lufla/CIC_Testing/docs/QC Testing Overview.pdf

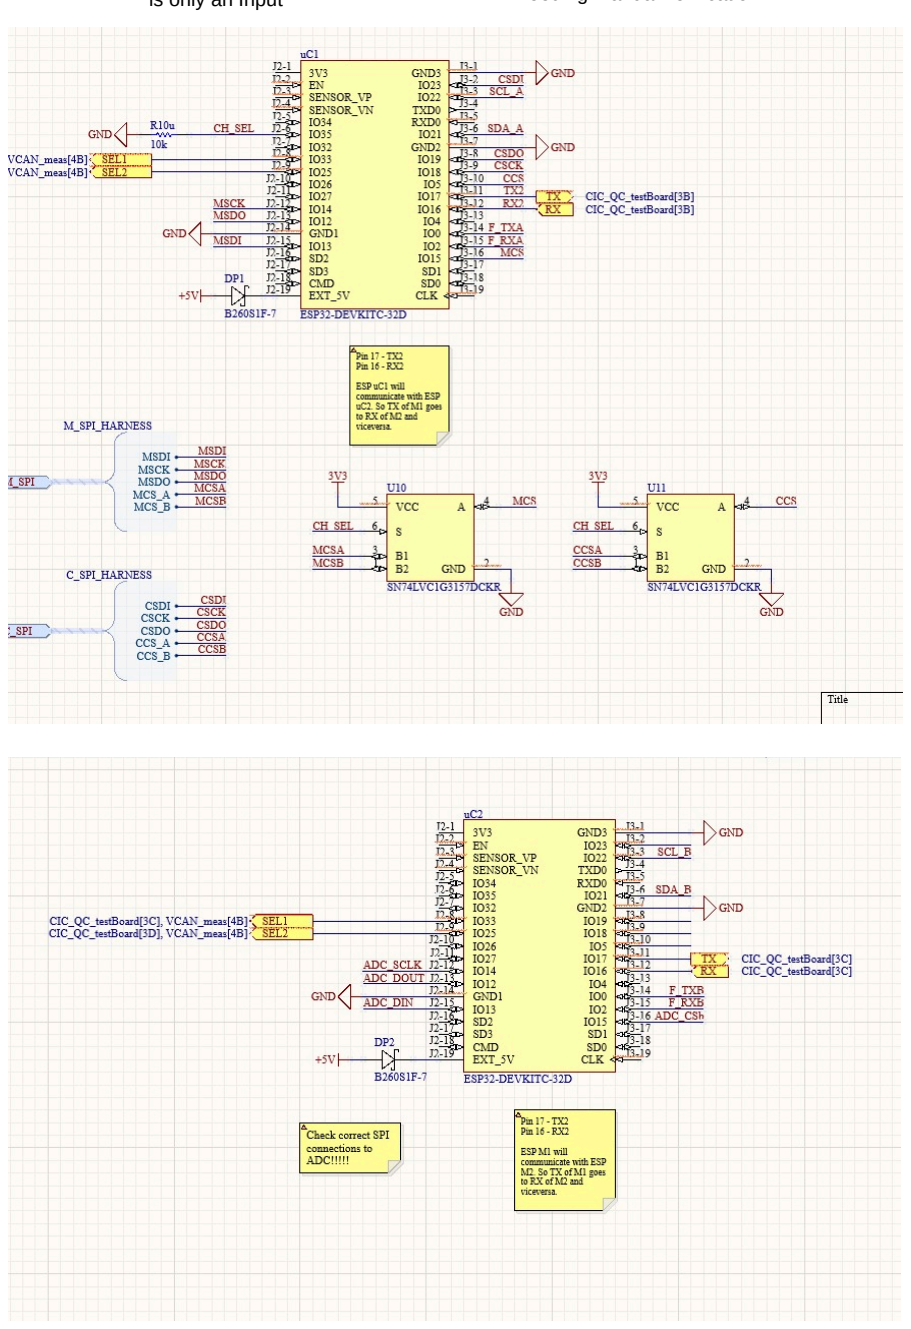
[picture p1: figure]

SPI (M read ADC messurements)

UART (Sent log of: - CAN A & B of RX/TX - VCAN V & A of CIC - VCAN V A & B - CIC ADC mesurements -Master has set ID (needed for connecting multiple QA Tester at once) This ID will be pressent in the terminal TXD0/RXD0

Master

First execute 3.2 - 3.3 if it work, only then let it run at max. V & C for 9min to heatup, then

start with the CAN 3.5 - 3.6! 3.4 in parallel to 3.2-3.6, also on slave in parallel Count CAN errors like CRC or error Frames

UART TX/RX
| (Sent & Receive CAN messages + Crosstalk (both directions depending on Crosstalk direction test),
| VCAN V & A, Power ADC)

Slave First execute 3.2 - 3.3 if it work, only then let it run at max. V & C for 9min to heatup, then

start with the CAN 3.5 - 3.6! 3.4 in parallel to 3.2-3.6, also on master in parrallel Count CAN errors like CRC or error Frames

Voltage & Current for Bus M comp.: CIC power (3V3) | Voltage & Current for SPI C comp.: ADC of the CIC (VCAN)

ADC 4x
channel

SPI (ADC readout V & A for CIC C & M)

I²C A(read V & set current (only set after VCAN Voltage was set))

Voltage, GND and Current of VCAN A

VCAN
+/-

I²C A(read V & set current (only set after VCAN Voltage was set)) VCAN
+/-

SPI (C set Voltage of the VCAN A & B)

F_TXB/F_RXB (CAN communication) TX: 0x580 + NodeID, msg 0 RX: 0x700 + NodeID, msg 0

F_TXA/F_RXA (CAN communication) TX: 0x580 + NodeID, msg 0 RX: 0x700 + NodeID, msg 0

PC

Python script

Menue + Options: 1. Enter Serial Number or use Barcode Scanner After 1 Print SN, Name, Date, Time

2. All values OK? (Name, Date, Time, etc. Time and Date autimatical) 2.1 Editor menue

2.2 OK, then 3. 3.1 START ALL

3.2 Test Voltage CH: A| B| Both (Only A or B at the same time) 3.3 Test Current CH: A| B| Both (Only A or B at the same time and Voltage must be set before current) 3.4 Test Temperature CH: A| B| Both (Only A or B at the same time) 3.5 Test CAN CH: A| B| Both (for 1 min or 1000msg?) 3.6 Test Crosstalk CH: A aktive| B aktive (for 1 min or 1000msg?) 4. After 3.1,.2,....6: Display results and then Save & END + override file if already existing|| repeat 1.X, 2.X or 3.X? || NEW Test with differen t CIC connected? Optional: Enter current load test (terminal: set current in a range + Ender, current is set; it changes after another commant + Enter; it ends on tpye END or end + Enter

Generate folder for each SerialNumber File: X.csv Test_all, which gets filled by (olnly when executed):

Voltage_mesurements_SerialNumber.csv Current_mesurements_SerialNumber.csv Tempreture_mesurements_SerialNumber.csv CAN_mesurements_SerialNumber.csv Crosstalk_mesurements_SerialNumber.csv

Grapth CIC_AQ_AC_123456789.csv See example: CIC_QA_QC.csv

END, upload to CERN database? Y/N New CIC connected

Level Shifter

Level Shifter

Arduino Shield NodeID = 1:
CAN Receive: ID = 0x581, msg = 00, 00, 00, 00, 00, 00, 00, 00 CAN Sent: ID = 0x701, msg = 00, 00, 00, 00, 00, 00, 00, 00 Receive and Sent is on CAN and for testing on Adruino UART

Arduino Shield NodeID = 2:
CAN Receive: ID = 0x582, msg = 00, 00, 00, 00, 00, 00, 00, 00 CAN Sent: ID = 0x702, msg = 00, 00, 00, 00, 00, 00, 00, 00 Receive and Sent is on CAN and for testing on Adruino UART

Voltage, GND and Current of VCAN B

Tell the USER to switch all SWITCHES TO OFF (A&B) initaly: Test if VCAN on CIC ADC and QC tester (I²C) stay 0V pass; then USER switch all SWITCHES TO ON. Afterwords an automated bit cobination testing (256 bits) happens to verify that only on the correct combination 1,25V;1,9V;2,0V;2,4V;2,6V;2,8V;3,5V;4,2V;4,6V

Switch Box

QA/QC
Tester | CIC

SPI C: MCP23S08-E/SO

ADC
ADC124S021CIMMX/NOPB

Voltage ADC
TLA2022IRUGR
Current DAC MCP4726A0T-E/CH

Voltage ADC
TLA2022IRUGR
Current DAC MCP4726A0T-E/CH

Main Task Set SPI ADC + values rx/tx, Set I²C ADC + values tx/tx, CAN rx/tx and forwart over UART

Main Task Set 2x SPI ADC + values rx/tx, Set I²C ADC + values tx/tx, CAN rx/tx, forwart over UART if needed and rx/tx to python

Mai task: Terminal input and output, Sent states to master, a csv, depending on 3.X, fill the CSV with the information

SPI M: CS5523-ASZ

TODO Hieraus ein flow diagram machen damit jeder nachvollziehen kann was passiert

IO 34 moved to 32, because 34
is only an Input

NEW FUNCTION 34: Master pull down Slave pull up

this is done to automate who is who, without needing manual verification
