lufla/CIC_Testing/docs/QC Testing of the CIC.drawio.pdf

UART
TXD0/RXD0
(Sent log of:
- CAN A & B of RX/TX
- VCAN V A & B
- VCAN V & A of CIC
- CIC ADC mesurements
M t h | t ID ( | d d f | ti | lti l QA T t | t | )

Python script

Menue + Options:
1. Enter Serial Number or use Barcode Scanner
After 1 Print SN, Name, Date, Time
2. All values OK? (Name, Date, Time, etc. Time and Date autimatical) 2.1 Editor menue
2.2 OK, then 3.
3.1 START ALL
3.2 Test Voltage CH: A| B| Both (Only A or B at the same time) 3.3 Test Current CH: A| B| Both (Only A or B at the same time and Voltage must be set before current) 3.4 Test Temperature CH: A| B| Both (Only A or B at the same time) 3.5 Test CAN CH: A| B| Both (for 1 min or 1000msg?)
3.6 Test Crosstalk CH: A aktive| B aktive (for 1 min or 1000msg?)
4. After 3.1,.2,....6: Display results and then Save & END + override file if already existing|| repeat 1.X, 2.X or 3.X? || NEW Test with differen t CIC connected? Optional: Enter current load test (terminal: set current in a range + Ender, current is set; it changes after another commant + Enter; it ends on tpye END or end + Enter

Gen

Test_all, w
Volta
Curre
Tempre
CAN
Cross

CIC_AQ_AC_12345
See exampl
CIC_QA_QC.

New CIC connected

PC

Mai task: Terminal input and output, Sent states to master, a csv, depending on 3.X, fill the CSV with the information

T

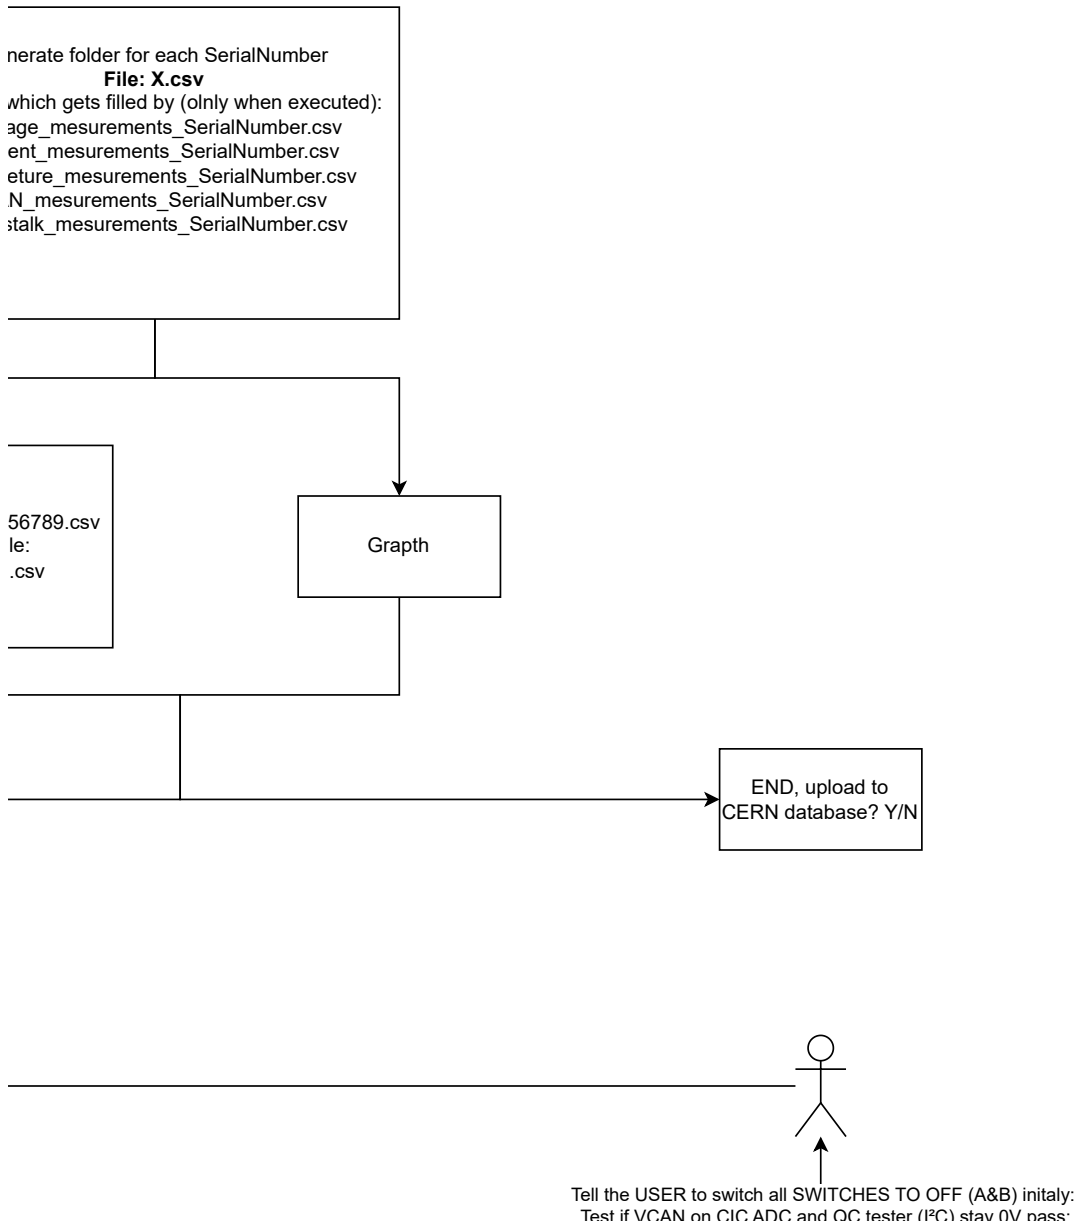
[picture p2: figure]
nerate folder for each SerialNumber File: X.csv; age_mesurements_SerialNumber.csv ent_mesurements_SerialNumber.csv eture_mesurements_SerialNumber.csv AN_mesurements_SerialNumber.csv stalk_mesurements_SerialNumber.csv; Grapth; 56789.csv le: .csv; END, upload to CERN database? Y/N

which gets filled by (olnly when executed):

Tell the USER to switch all SWITCHES TO OFF (A&B) initaly: Test if VCAN on CIC ADC and QC tester (I²C) stay 0V pass;

TODO Hieraus ein flow diagram machen damit jeder nachvollziehen kann was passiert

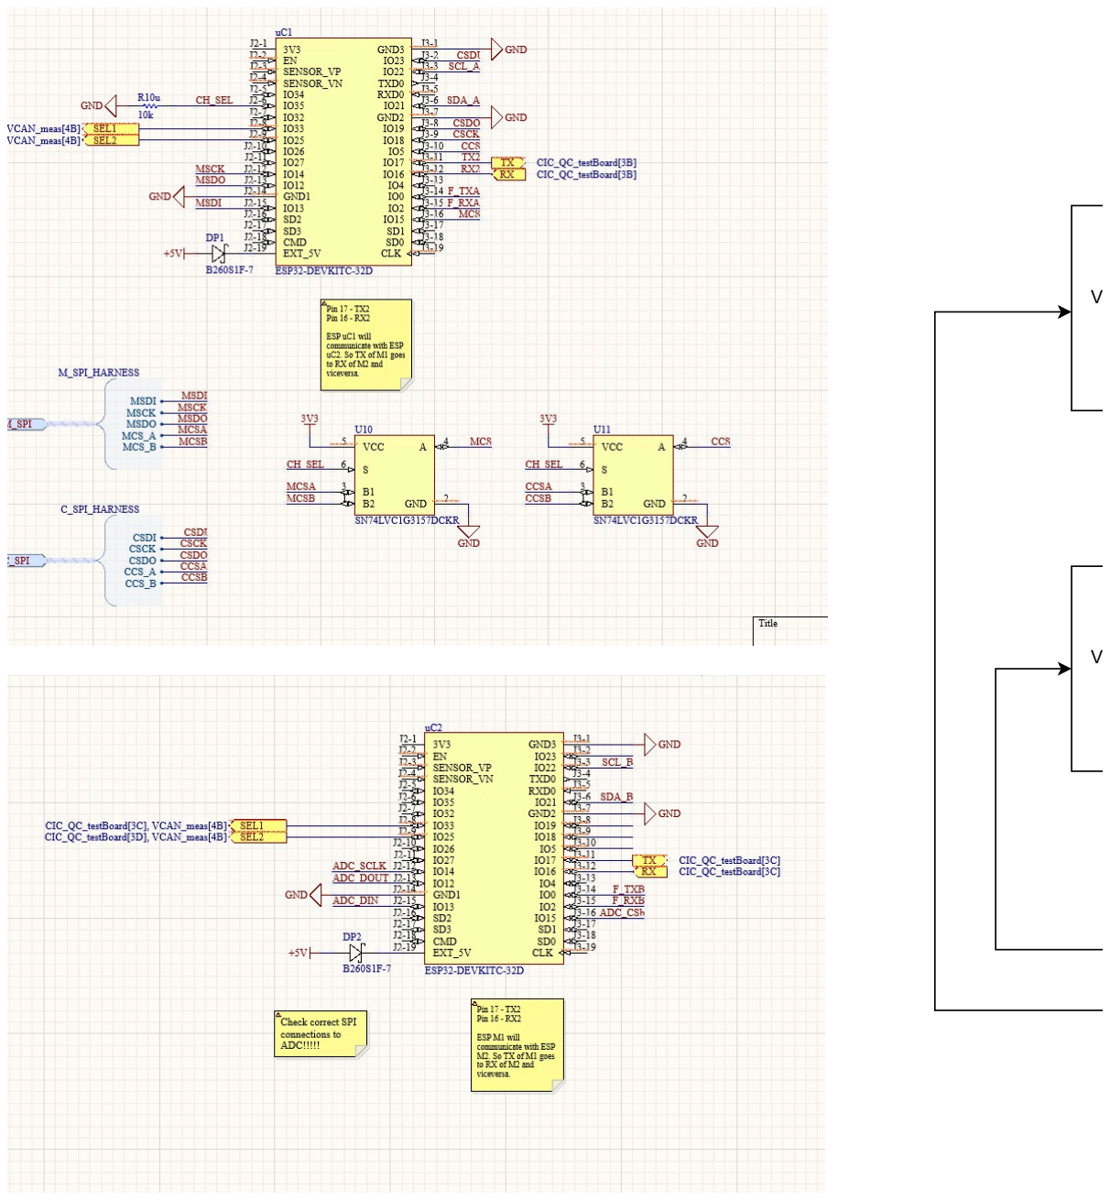
[picture p3: page 5]

VV

SPI (M read ADC messurements)

-Master has set ID (needed for connecting multiple QA Tester at once) This ID will be pressent in the terminal

Master

First execute 3.2 - 3.3 if it work, only then let it run at max. V & C for 9min to heatup, then start with the CAN 3.5 - 3.6! 3.4 in parallel to 3.2-3.6, also on slave in parallel
Count CAN errors like CRC or error Frames

UART TX/RX
| (Sent & Receive CAN messages + Crosstalk
| (both directions depending on Crosstalk direction test),
VCAN V & A, Power ADC)

Slave

First execute 3.2 - 3.3 if it work, only then let it run at max. V & C for 9min to heatup, then start with the CAN 3.5 - 3.6! 3.4 in parallel to 3.2-3.6, also on master in parrallel Count CAN errors like CRC or error Frames

Voltage & Current fo
Bus C: CIC power

SPI (ADC readout V & A for CIC C

I²C A(read V & set current (only set after VCAN Voltage was set))

Voltage, GND and Current of VCAN A

VCAN
+/-

I²C A(read V & set current (only set after VCAN Voltage was set))

VCAN
+/-

SPI (C set Voltage of the VCAN A & B)

F_TXB/F_R
TX: 0x5
RX: 0x7

F_TXA/F_RXA (CAN communication) TX: 0x580 + NodeID, msg 0
RX: 0x700 + NodeID, msg 0

Voltage, GND and Current of VCAN B

QA/QC
Tester

Voltage ADC
TLA2022IRUGR
Current DAC
MCP4726A0T-E/CH

Voltage ADC
TLA2022IRUGR
Current DAC
MCP4726A0T-E/CH

Main Task Set SPI ADC + values rx/tx, Set I²C ADC + values tx/tx, CAN rx/tx and forwart over UART

Main Task Set 2x SPI ADC + values rx/tx, Set I²C ADC + values tx/tx, CAN rx/tx, forwart over UART if needed and rx/tx to python

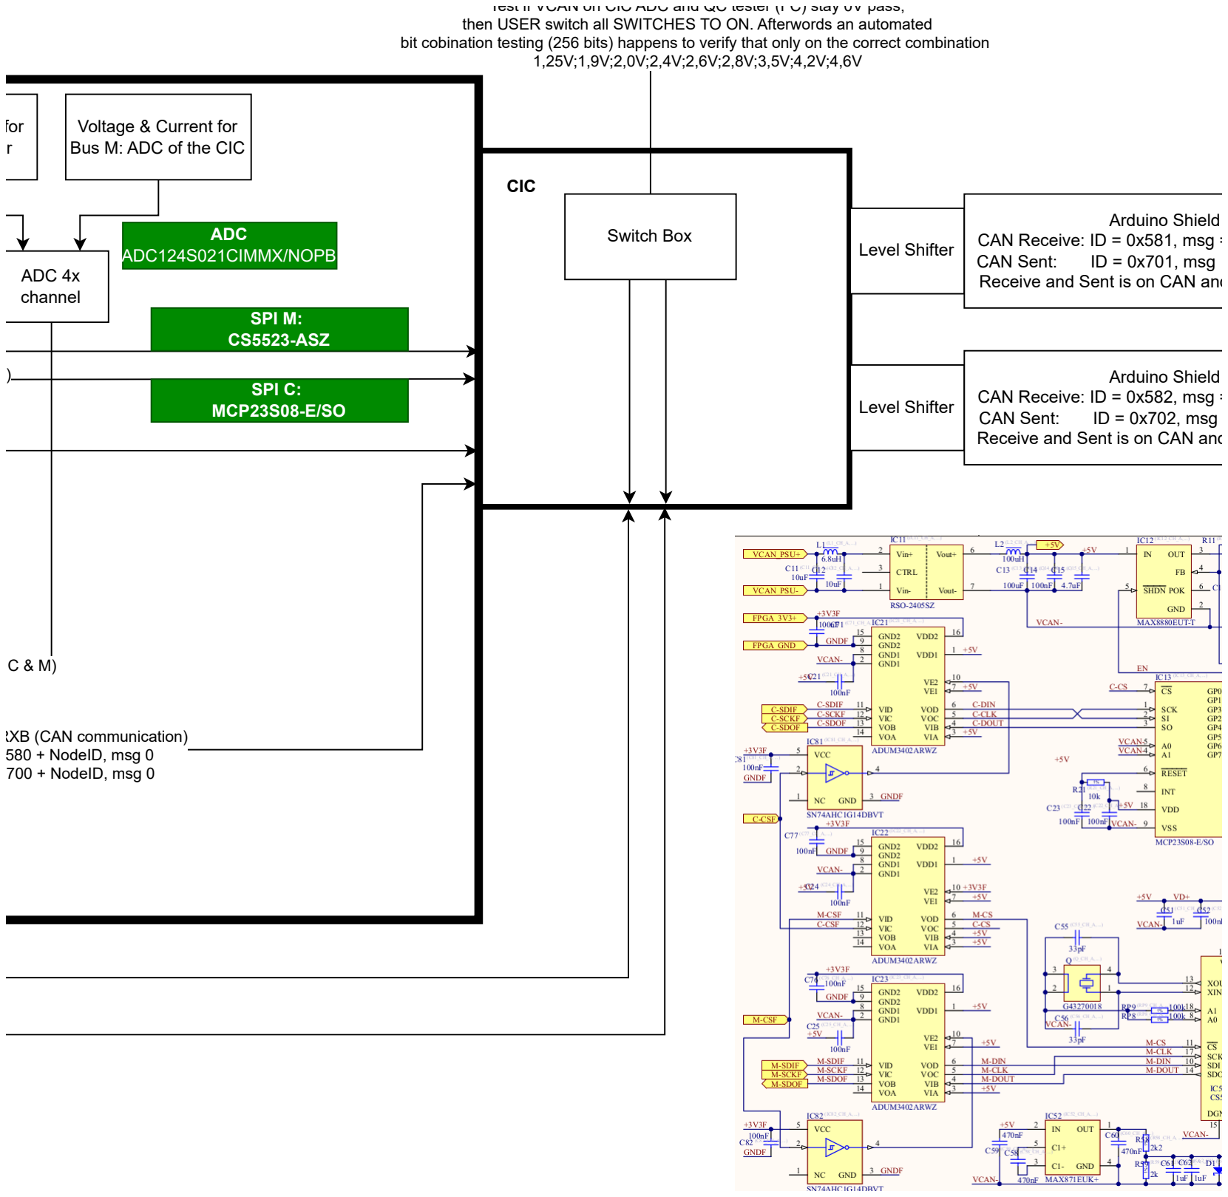
[picture p4: figure]
for r; Voltage & Current for Bus M: ADC of the CIC; ADC 4x channel; RXB (CAN communication) 580 + NodeID, msg 0 700 + NodeID, msg 0; Level Shifter; Arduino Shield CAN Receive: ID = 0x581, msg =; CAN Sent:; ID = 0x701, msg; Receive and Sent is on CAN and; Arduino Shield CAN Receive: ID = 0x582, msg =; ID = 0x702, msg; Switch Box; CIC; SPI C: MCP23S08-E/SO; ADC ADC124S021CIMMX/NOPB; SPI M: CS5523-ASZ

Test if VCAN on CIC ADC and QC tester (I C) stay 0V pass; then USER switch all SWITCHES TO ON. Afterwords an automated
bit cobination testing (256 bits) happens to verify that only on the correct combination

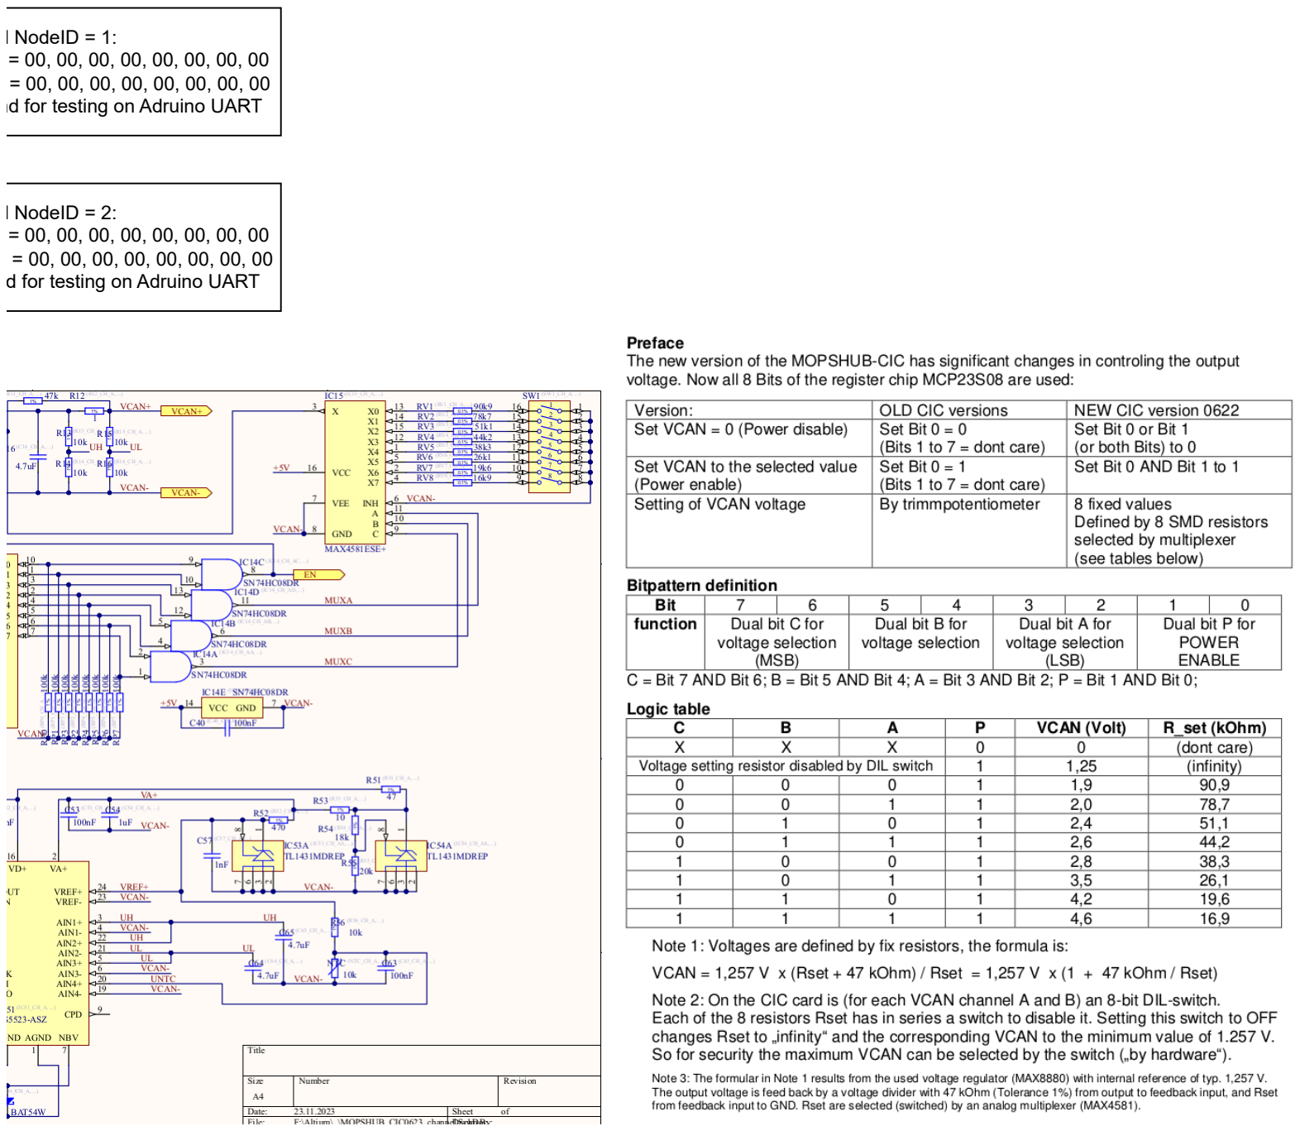
[picture p5: page 8]

d NodeID = 1:
= 00, 00, 00, 00, 00, 00, 00, 00 = 00, 00, 00, 00, 00, 00, 00, 00 nd for testing on Adruino UART

d NodeID = 2:
= 00, 00, 00, 00, 00, 00, 00, 00 = 00, 00, 00, 00, 00, 00, 00, 00 d for testing on Adruino UART
