lufla/CIC_Testing/docs/CIC_QA_QC.ods

CIC QA/QC Measurements
QA/QC Technician | Date | Time | Serial Number | Room Temperature in °C | QA_QC BOARD ID | Acceptance of the Hardware
Lukas Flad | 21.08.25 | 19:55:00 | 123456789 | 25 | 2 | FAILED
Accepted measurements | VCAN Voltage min. (-1%) | VCAN Voltage nominal | VCAN Voltage max. (+1%) | VCAN PSU A min. | VCAN PSU A nominal | VCAN PSU A max. (+10%) | VCAN PSU V min. (-10%) | VCAN PSU V nominal | VCAN PSU V max. (+10%) | Temperature min. in °C | TX sent | RX msg Channel A | TX msg Channel A | RX/TX msg lost or corrupted eg. Error Frame | VCAN DAC Current vectors
 | 0 | 0 | 0 | 0 | 50mA | 55mA | VCAN PSU V nominal – 10% | User Input VCAN PSU V * 8 | VCAN PSU V nominal +10% | 10 | 30000 | 0x701 00 00 00 00 00 00 00 00 | 0x581 00 00 00 00 00 00 00 00 | 0 | 0
 | 1.25 | 1.25 | 1.25 |  |  |  |  |  |  |  |  |  |  |  | max_current / 5
 | 1.81 | 1.90 | 1.99 |  |  |  |  |  |  |  |  |  |  |  | max_current / 4
 | 1.90 | 2.00 | 2.10 |  |  |  |  |  |  |  |  |  |  |  | max_current / 3
 | 2.28 | 2.40 | 2.52 |  |  |  |  |  |  |  |  |  |  |  | max_current / 2
 | 2.47 | 2.60 | 2.73 |  |  |  |  |  |  |  |  |  |  |  | max_current / 1
 | 2.66 | 2.80 | 2.94
 | 3.33 | 3.50 | 3.67
 | 4.09 | 4.30 | 4.51
 | 4.47 | 4.70 | 4.93
Accepted measurements | VCAN Current min. | VCAN Current nominal | VCAN Current max. | CIC power A min. | CIC power A nominal | CIC power A max. (+10%) | CIC power V min. (-10%) | CIC power V nominal | CIC power V max. (+10%) | Temperature max. in °C | RX received | RX msg Channel B | TX msg Channel B | Crosstalk
 | 0.07 | 0.04 | 140mA | 0 | 10mA | 11mA | 2.97 | 3.3 | 3.63 | ??????????85 | 30000 | 0x702 00 00 00 00 00 00 00 00 | 0x782 00 00 00 00 00 00 00 00 | 0
Acceptance | Voltage VCAN A | Voltage VCAN B | Voltage CIC | Voltage CIC ADC | Current VCAN A | Current VCAN B | Current CIC | Current CIC ADC | Room Temperature | RX Channel A | TX Channel A | RX Channel B | TX Channel B | Crosstalk A to B | Crosstalk B to A
PASS || FAILED | FAILED | PASS | PASS | PASS | PASS | PASS | PASS | PASS | PASS | PASS | PASS | PASS | PASS | PASS | FAILED
Reason | 1.4; 1.5;1.4 |  |  |  |  |  |  |  | 25 | 30000 | 30000 | 30000 | 30000 | 0 | 1
Values in one line do not correlate in time, else there would be way to much fast data
Measurements | Voltage VCAN A | Voltage VCAN B | Voltage CIC | Voltage CIC ADC | Current VCAN A | Current VCAN B | Current CIC | Current CIC ADC | Room Temperature | RX Channel A | TX Channel A | RX Channel B | TX Channel B | Crosstalk A to B | Crosstalk B to A | User Input VCAN PSU V
1 | 1.90 | 1.90 | ?? | ?? | ?? | ?? | ?? | ?? | 25 | 0x701 00 00 00 00 00 00 00 00 | 0x581 00 00 00 00 00 00 00 00 | 0x702 00 00 00 00 00 00 00 00 | 0x782 00 00 00 00 00 00 00 00 | 0 | 0
2 |  |  |  |  |  |  |  |  | 24
3 |  |  |  |  |  |  |  |  | 26
4
