lufla/CIC_Testing/docs/Flow_Diagramm_QC.pdf

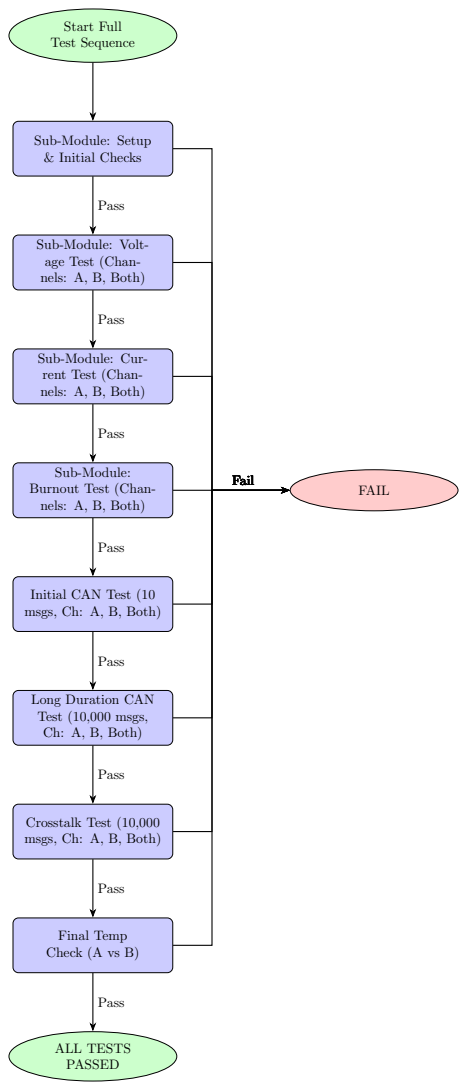
[picture p6: page 1]
Start Full Test Sequence; Final Temp Check (A vs B); ALL TESTS PASSED; FAIL; Pass; Fail

Sub-Module: Setup
& Initial Checks

Sub-Module: Volt-
age Test (Chan-
nels: A, B, Both)

Sub-Module: Cur-
rent Test (Chan-

Sub-Module:
Burnout Test (Chan-

Initial CAN Test (10
msgs, Ch: A, B, Both)

Long Duration CAN
Test (10,000 msgs,
Ch: A, B, Both)

Crosstalk Test (10,000

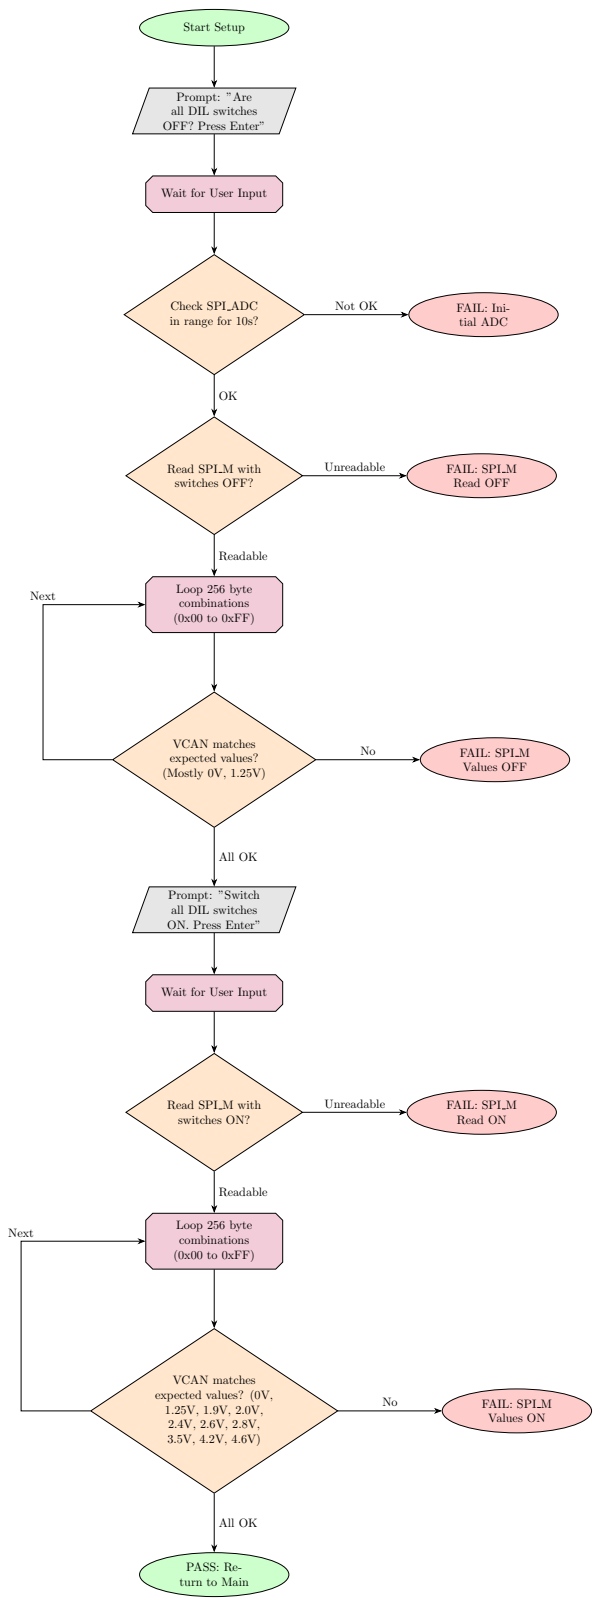
[picture p7: page 2]
Start Setup; Loop 256 byte combinations (0x00 to 0xFF); VCAN matches expected values? (Mostly 0V, 1.25V); VCAN matches expected values? (0V, 1.25V, 1.9V, 2.0V, 2.4V, 2.6V, 2.8V, 3.5V, 4.2V, 4.6V); FAIL: Ini- tial ADC; FAIL: SPI M Read OFF; FAIL: SPI M Values OFF; FAIL: SPI M Read ON; FAIL: SPI M Values ON; Readable; All OK; Next; Not OK; Unreadable

Prompt: ”Are
all DIL switches
OFF? Press Enter”

Wait for User Input

Check SPI ADC
in range for 10s?

Read SPI M with
switches OFF?

Prompt: ”Switch
ON. Press Enter”

switches ON?

PASS: Re-
turn to Main

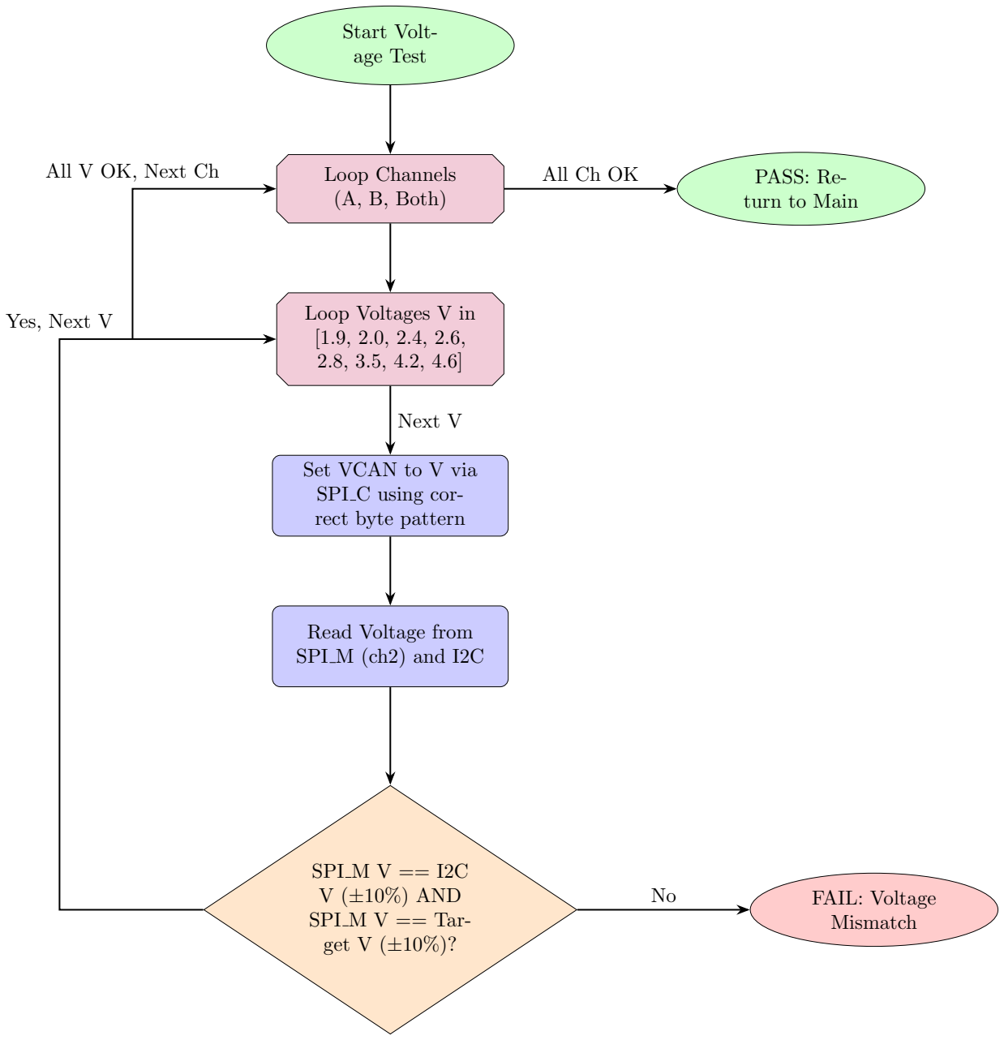
[picture p8: figure]
Start Volt- age Test; Loop Channels (A, B, Both); Loop Voltages V in [1.9, 2.0, 2.4, 2.6, 2.8, 3.5, 4.2, 4.6]; Set VCAN to V via SPI C using cor- rect byte pattern; Read Voltage from SPI M (ch2) and I2C; SPI M V == I2C V (±10%) AND SPI M V == Tar- get V (±10%)?; PASS: Re- turn to Main; FAIL: Voltage Mismatch; Next V; Yes, Next V; All V OK, Next Ch; All Ch OK
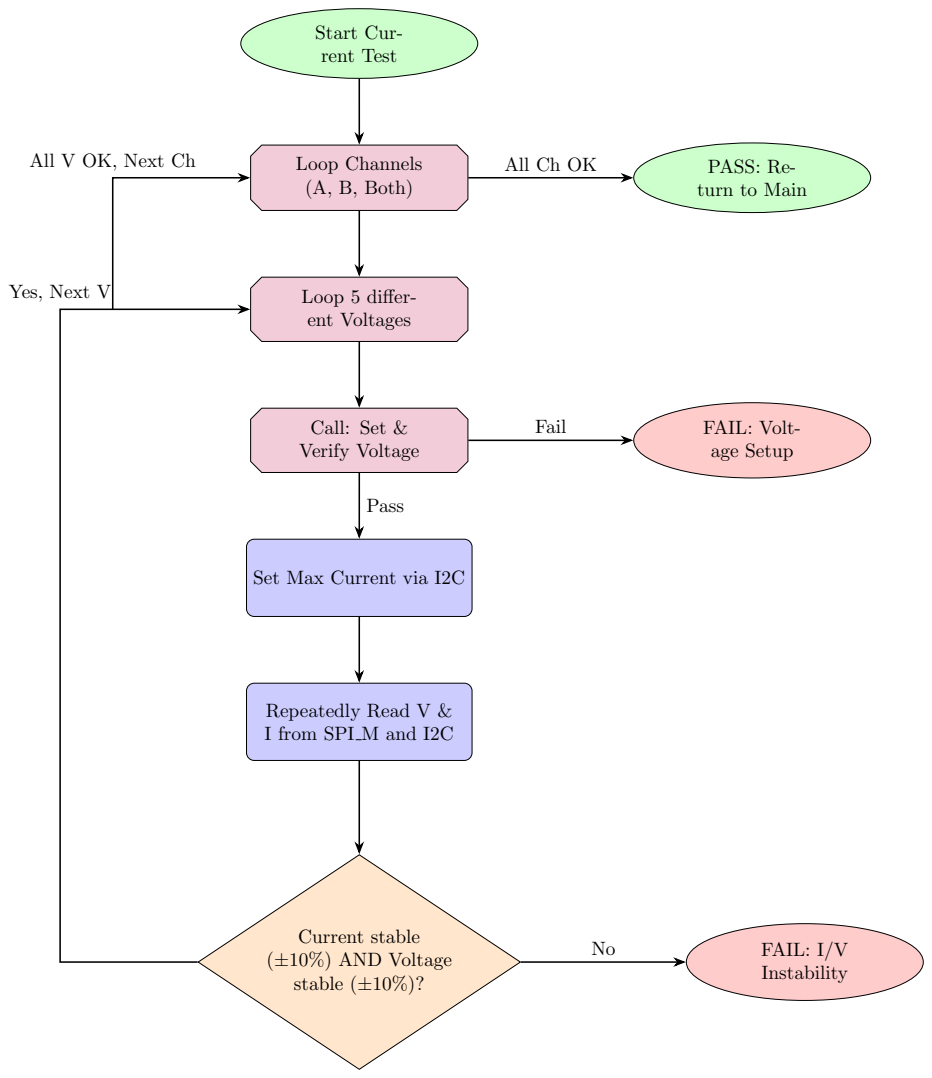
[picture p9: page 4]
Start Cur- rent Test; Loop Channels (A, B, Both); Loop 5 differ- ent Voltages; Call: Set & Verify Voltage; Current stable (±10%) AND Voltage stable (±10%)?; FAIL: Volt- age Setup; FAIL: I/V Instability; Pass; Yes, Next V; All V OK, Next Ch; All Ch OK; Fail

PASS: Re-
turn to Main

Set Max Current via I2C

Repeatedly Read V &
I from SPI M and I2C

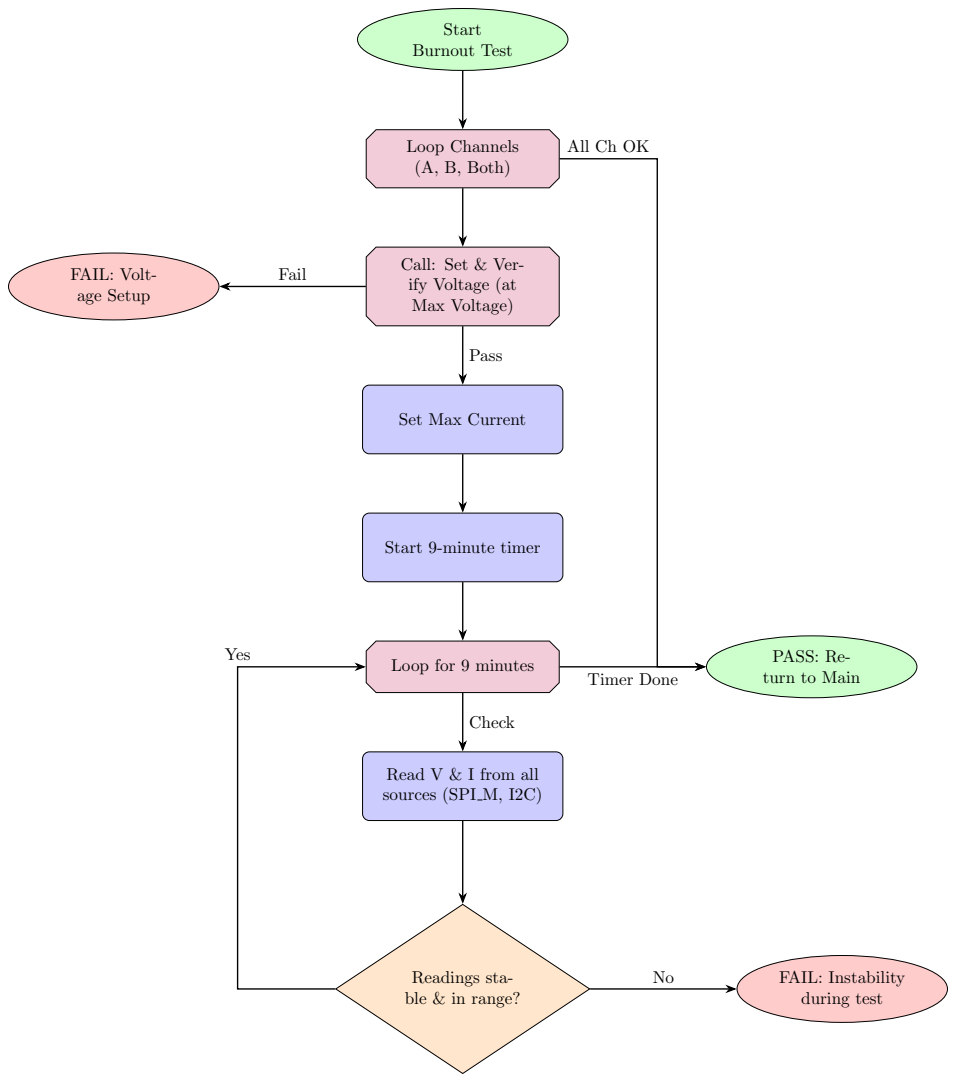
[picture p10: page 5]
Start Burnout Test; Loop Channels (A, B, Both); FAIL: Volt- age Setup; FAIL: Instability during test; Pass; Check; Yes; Timer Done; Fail

All Ch OK

Call: Set & Ver-
ify Voltage (at
Max Voltage)

Set Max Current

Start 9-minute timer

Loop for 9 minutes

PASS: Re-
turn to Main

Read V & I from all
sources (SPI M, I2C)

Readings sta-
ble & in range?

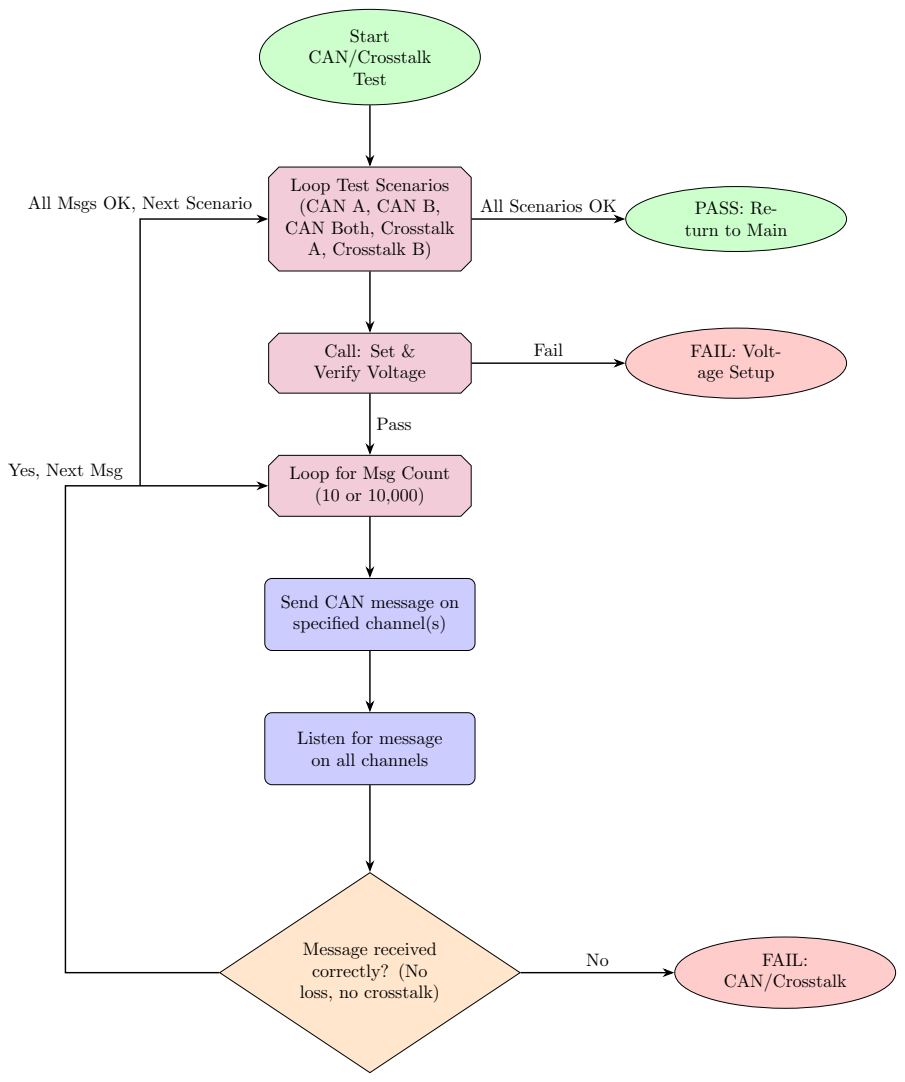
[picture p11: page 6]
Start CAN/Crosstalk Test; Call: Set & Verify Voltage; FAIL: Volt- age Setup; FAIL: CAN/Crosstalk; Pass; All Msgs OK, Next Scenario; All Scenarios OK; Fail

Loop Test Scenarios
(CAN A, CAN B,
CAN Both, Crosstalk
A, Crosstalk B)

PASS: Re-
turn to Main

Yes, Next Msg

Loop for Msg Count

Send CAN message on
specified channel(s)

Listen for message
on all channels

Message received
correctly? (No
loss, no crosstalk)
