lufla/CIC_Testing/(commit log)

2025-08-25 fist commit of all current files of the CIC tesing setup
    [CIC_QA_QC.ods, CIC_QC_1111_Voltage_20250825_115047.csv, CIC_QC_11234_Voltage_20250825_115459.csv, CIC_QC_11234_Voltage_20250825_115727.csv, CIC_QC_1127_Voltage_20250825_112751.csv, CIC_QC_1127_Voltage_20250825_112935.csv, CIC_QC_1127_Voltage_20250825_113054.csv, CIC_QC_1149_Voltage_20250825_114937.csv]
2025-08-25 addded functions to run a full test; missing are T, C, CAN, X-talk for test, but python is ready. also initial files like requirments and initial jason with shortant time and msg
    [CIC_QC_1111_Voltage_20250825_115047.csv, CIC_QC_11234_Voltage_20250825_115459.csv, CIC_QC_11234_Voltage_20250825_115727.csv, CIC_QC_1127_Voltage_20250825_112751.csv, CIC_QC_1127_Voltage_20250825_112935.csv, CIC_QC_1127_Voltage_20250825_113054.csv, CIC_QC_1149_Voltage_20250825_114937.csv, CIC_QC_1234_Voltage_20250825_120515.csv]
2025-08-26 added isolated test of the SPI M and C
2025-08-27 added todos adn isolated SPI and I2C communication tests
    [CIC_QA_QC.ods, CIC_QC_1234_Voltage_Exhaustive_20250826_175320.csv, CIC_QC_1234_Voltage_Exhaustive_20250826_175736.csv]
2025-08-29 add isoated test, where the code is fused. Inital test PASS, Switch OFF PASS, ON muunder testing
2025-08-30 added SPI set voltage for on and off correctly
    [STEP_BY_STEP.ino, initial_checks.py, master_spi_handler.cpp, master_spi_handler.h, slave_spi_handler.cpp, slave_spi_handler.h, voltage_test.py]
2025-08-30 add current test and CAN in testing
2025-08-30 everything passed, apart from burnout
    [CAN_TWAI_lib.ino, STEP_BY_STEP.ino, burnout_test.py, can_handler.cpp, can_handler.h, can_test.py]
2025-08-30 git restructuring
    [CIC_QA_QC.ods, CIC_QC_1234_Voltage_Exhaustive_20250826_175320.csv, CIC_QC_1234_Voltage_Exhaustive_20250826_175736.csv]
